hpaluch/temp_meter_16f630/(list of files, drawings)

Other design files:
ExpressPCB/temp_meter_16F630.pcb
