hpaluch/temp_meter_16f630/(threads)

Thread 1 (2022-09-30):

Hardware bug

Wheels39, 2022-09-30:
There is a resistor missing between the collector of Q3 and the base of Q2.  4k7 works fine.

hpaluch, 2022-12-22:
Hi!
It is actually intentional - something called: https://en.wikipedia.org/wiki/Sziklai_pair
In my case it works even without that resistor as can be seen on image:

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

Could try it without that resistor if it still works for you?

Wheels39, 2022-12-22:
Hi,I'd forgotten I'd made that comment, it's so long ago!  Monitor the supply current, you will see the problem. The driving transistor isn't being allowed to saturate for want of a collector load.  Good little project though, works fine for me too.  Regards-- Sent from my Android phone with GMX Mail. Please excuse my brevity.On 22/12/2022, 09:33 Henryk Paluch ***@***.***> wrote:

  Hi! It is actually intentional - something called: https://en.wikipedia.org/wiki/Sziklai_pair In my case it works even without that resistor as can be seen on image:

  Could try it without that resistor if it still works for you?
  —Reply to this email directly, view it on GitHub, or unsubscribe.You are receiving this because you authored the thread.Message ID: ***@***.***>

hpaluch, 2022-12-23:
Hi!
Thank you for your effort! It woke up my curiosity - I plan to rebuild this circuit to see what is going there. Please stay tuned.

hpaluch, 2022-12-27:
Hi, @Wheels39 !

Confirmed (with my nose touching Q1, Q2, and Q3 respectively - Q3 was hot) and fixed adding resistor as you proposed in 4be9fff

Thank you for contribution!

Closed 2022-12-27.
