hpaluch/temp_meter_16f630/(commit log)

2013-06-10 Preliminary schematics
    [temp_meter_16F630.sch]
2013-06-10 Symbol for LED display HD-A544D
    [temp_meter_16F630.sch]
2013-06-10 Skeleton of init and interrupt
2013-06-10 Fixed strange prescaler behaviour
    [intr.asm, main.asm]
2013-06-11 Better solution to Timer issue
    [intr.asm, main.asm]
2013-06-11 Earlier ACK of timer interrupt
2013-06-12 Fixed Buggy Device Not Present condition
    [ds18b20.asm]
2013-06-12 Now show temperature in Decimal. TODO: negative temp
2013-06-12 Support for negative temperature
2013-06-13 Corected NetList errors. Added proper transistor symbols
    [temp_meter_16F630.sch]
2013-06-13 Added PNG schematics
2013-06-13 New fixed transistors in schematics
    [temp_meter_16F630.sch]
2013-06-14 Added Supply connector
    [temp_meter_16F630.sch]
2013-06-14 Added preliminary PCB and packages
    [temp_meter_16F630.pcb]
2013-06-14 Updated snaphost of schematics
2013-06-14 Proper orientation of ICSP connector
    [temp_meter_16F630.pcb]
2013-06-14 Jumper PCB package
2013-06-14 Use 1cm resistors
    [temp_meter_16F630.pcb]
2013-06-14 fixed text typo
    [temp_meter_16F630.pcb]
2013-06-16 Added packages for LED diode and Display
    [temp_meter_16F630.pcb]
2013-06-16 Preliminary yet complete version
    [temp_meter_16F630.pcb]
2013-06-16 Added tag PCB_DRAFT_1 for changeset 09b9143e9bf6
2013-06-16 Big PADs for TO-92 and little PCB optimization
    [temp_meter_16F630.pcb]
2013-06-16 PCB draft 2
    [temp_meter_16F630.pcb]
2013-06-16 Added tag PCB_DRAFT_2 for changeset 831fc24c2a81
2013-06-17 Just small fixes
    [temp_meter_16F630.pcb]
2013-06-18 Fixed reverse Connector PIN assignment
2013-06-18 Rev DRAFT 2
    [temp_meter_16F630.pcb]
2013-06-18 Rev DRAFT 3
    [temp_meter_16F630.pcb]
2013-06-18 Added tag PCB_DRAFT_3 for changeset dda301a5f15b
2013-08-31 Added image of Temp meter prototype
2022-12-27 Added packages layout for DS and tranzistors
    [temp_meter_16F630.sch]
2022-12-27 Updated image of prototype
2022-12-27 Notice self-heating problem + possible solutions from Arduion forum
2022-12-27 Added R12 to avoid overcurrent of Q3, fixes #1
    [temp_meter_16F630.pcb, temp_meter_16F630.sch]
2022-12-29 Updated png export of schematic + added github link
    [temp_meter_16F630.sch]
